msalaz03/ProjectClifford/README.md

# Project Clifford
* [Overview](#overview)
* [Setup](#setup)
  * [RVIZ with Clifford](#For-Using-RVIZ-With-Clifford)
  * [Launching Clifford](#For-Launching-and-Booting-Clifford)
* [Hardware](#hardware)
  * [Communication between Devices](#Communication-Protocol)
  * [FPV Camera](#FPV-Camera)
  * [Displaying Live Battery %](#Calculating-Battery-Life)
  * [Other Hardware](#Other-Useful-Components)
* [Software](#software)
* [Kinematics](#Inverse-Kinematics)
* [Future Additions](#future-additions)
* [Bill of Materials](#bill-of-materials)
* [References](#references)

## Overview (Please Read)
Over the past four months Cameron, Chase and I tried tackling our version of Boston Dynamic's Spot. This repository contains the source code that interfaces all hardware interactions between our small red friend. The software includes prebuilt libraries designed for the Raspberry Pi and also references other projects similar to ours. 

Now then, running on Ubuntu 22.04 LTS using ROS-Humble we went through a series of processes to organize this into a simple manner. However, we will note that they're some poor practices as a result of time constraints and it is our first time working with the ROS framework. These will be noted and clarified further in this document. Clifford is an entirely 3D-printed project that uses inverse kinematics to simulate a dog walking. Clifford also has an FPV camera mounted which can be accessed through any web browser provided you're on the same network as him.

Please check the references, this would have not been possible without open-source projects. 



## Video Demo:
https://youtube.com/shorts/WbrB4VmLomk?feature=share

## Setup
The organization of nodes is not ideal. However, with time it can be reorganized neatly. Currently, we have mostly everything inside a single node. For anyone attempting to recreate anything similar please take the time to do so before programming the entire project.

```
Three most important folders for this project.

projectclifford_ws/
│
├── src/
│   ├── clifford_sim_1
│   │   └── ...
│   ├── servo_driver
│   │   └── ...  
│   └── ...
│   ├── teleop_controller
│   │   └── ...  
│   └── ...
```

#### For Using RVIZ With Clifford
To test our kinematic equations more efficiently we used RVIZ to visualize what is happening when there is a controller input. 'clifford_sim_1' contains a URDF file for the final version of Clifford, exported through SolidWorks URDF exporter. The launch file within this directory only launches the URDF file into RVIZ and does not contain RobotStatePublisher by default. You can enable joint-state-publisher-gui by uncommenting the related lines within the launch file or can use an additional launch file that waits for joy (controller input) and joint-state-publisher topic. The second directory relative to running RVIZ is 'teleop_controller' which creates a topic for joint-state-publisher.

**NOTE:** This totally could have been organized into a single launch file but wasn't due to circumstances at the time.

In order to launch please do the following.

```
ros2 launch clifford_sim_1 clifford_sim_1.launch.py
ros2 launch teleop_controller Clifford_full_model.launch.py
```
#### For Launching and Booting Clifford

To physically launch Clifford is pretty simple (as long as you have all required dependecies), simply run the following command.

**Note:** At this point Clifford cannot physically turn as the turning motion was not programmed, however the kinematic equations needed to do are solved and within the software.
```
ros2 launch servo_driver joy_servos.launch.py
```

If you want don't want to follow Clifford, you can see where he is through livestreamed footage. First identify the IPV4 address of clifford and type the following.
```
xxx.xxx.xxx.xxx:8081
```

## Hardware
From researching similar projects to Clifford and our testing we sourced components that we thought were optimal for this project, consisting of two voltage regulators to isolate the power going into the servo driver and Raspberry Pi. An ADC board to measure different voltage levels into a relative percentage for battery life. A high-capacity battery to prolong battery life. LCD screen to demonstrate battery life in real time. 25 KG servos, a mixture of torque and speed to ensure smooth movements. 

<br>
  
<table>
  <tr>
    <td> <b>Electrical Component </b></td>
    <td>  <b>Model Name </b>  </td>
  </tr>

  <tr>
    <td>Controller</td>
    <td>Raspberry Pi 4B</td>
  </tr>

  <tr>
    <td> Camera </td>
    <td> Arducam 16MP Wide Angle USB Camera </td>
  </tr>
  
   <tr>
    <td>Voltage Regulator for Pi</td>
    <td>LM2596</td>
  </tr>

 <tr>
    <td>Voltage Regulator for Servos</td>
    <td>DROK DC-DC High Power </td>
  </tr>

 <tr>
    <td>LiPo Battery</td>
    <td>Zeee 2S LiPo 6200mAh @ 7.4V</td>
</tr>

 <tr>
    <td>Servos</td>
    <td>DS3225MG</td>
</tr>

 <tr>
    <td>Servo Driver</td>
    <td>PCA9685</td>
</tr>

 <tr>
    <td>ADC Board</td>
    <td>ADS1115</td>
</tr>

 <tr>
    <td>Gyroscope</td>
    <td>MPU-6050</td>
</tr>

 <tr>
    <td>LCD 16x2</td>
    <td>Sunfounder LCD1602 16x2 </td>
</tr>
 
</table>

#### Communication Protocol 
As we were using multiple third-party modules such as servo driver we utilized the I2C bus provided on the Raspberry Pi 4B. This worked perfectly but didn't allow us to have multiple devices using I2C, as we had a few more. Creating a simple PCB using header pins we created an I2C bus expander that allowed all devices to meet at a single point to communicate with the Pi.

#### FPV Camera 
Using motion libraries we were able to set up a first-person live-streaming feed on a local network. By dedicating a specified port to live-streaming (8081) simply use the IPV4 address followed by the port like so xxx.xxx.xxx.xxx:8081 to access from any device on the same network. 
To set the config file for the motion service to work navigate to:
```
sudo nano /etc/default/motion
```
Make the following changes to the config file:
```
daemon on
stream_localhost off
webcontrol_localhost off
framerate 1500
stream_quality 100
quality 100
width 640
height 480
post_capture = 5
```
After that navigate to the default file:
```
sudo nano /etc/default/motion
```
Make sure the file contains the following if you want live streaming to start when turning on the Pi.
```
start_motion_daemon=yes
```
#### Calculating Battery Life 
Using the 5V pin provided to power the ADS1150, we needed to step down the balance charger voltage outputted from the LiPo. We created a small PCB board that included a voltage divider circuit such that the highest voltage read would be ~5V. Now with voltage being able to be read, we then determined the highest voltage ie @ 100% and at 0%. We then used the current voltage to calculate the current battery percentage.

#### Other Useful Components  
After finalizing the project here our somethings that help improve production. 
  - Buy a dedicated LiPo Battery Balance Charger, these will guarantee the quality of battery being used and can charge relatively quick.
  - Using a DC Power Supply, would prevent the need of constantly recharging the battery after testing.
  - If possible maximize the hardware you use. We settled on the Raspberry Pi 4B, it was okay. I figured I would do most of my programming on the Pi anyway but there were times it was just so slow.
  - Get a dedicated cooler for your controller, especially for the Raspberry Pi. These things will heat up quickly.

## Software
The software went through many revisions, currently, all software is under a single node, 'servo2_pca9685' within the directory 'servo_driver'. This includes the various kinematic equations needed to move each leg. The ultrasonic sensor can also be found within this file to override a controller input if Clifford detects he is too close to an object.

#### PS4 Joystick
Using the left joystick, you can determine the direction of movement (forward or backward). This is handled through flags that check the joy topic axes sign (-/+). Using the Joy topic callback we can constantly update Clifford's relative position. Clifford's walking consists of a 4-point leg motion. However, the legs move in pairs, meaning the front left and back right move together, and the front right and back left move together. The overall structure of the walking gait was as follows, a single set will take 'charge' meaning they're the legs move forward while the others are dragging backward creating the ability to go forward. The speed at which the legs drag backward is based on the input of the user, and timing so that a pair of legs complete a single point (the ones dragging backward) while the other completes three 3 (the other set). This allows us to constantly have two points of contact with the ground at all times.

The leg motion follows a square pattern, making the programming straightforward. At each position, the program checks whether the leg is moving forward or backward and its current relative position (x, y, z). Only one coordinate (either x or y) changes at a time. Multiple conditions verify if the leg has passed or reached its target coordinate, then update the target and current indices. While most of the programming remains consistent, the conditions for each leg differ slightly.

#### Sample Code
```
     if forward and self.front_right_current[2] >= self.front_right_target[self.set1_target_index][2] or \
                        (not forward and self.front_right_current[2] <= self.front_right_target[3][2]):
                            self.update_servos()
                    else:
                        if forward:
                            self.front_right_current[2] = self.front_right_target[self.set1_target_index][2]
                            self.back_left_current[2] = self.back_left_target[self.set1_target_index][2]

                            self.set1_target_index = 2 
                            self.set1_walk_index = 1
                        else:
                            self.front_right_current[2] = self.front_right_target[self.set1_walk_index][2]
                            self.back_left_current[2] = self.back_left_target[self.set1_walk_index][2]
                            self.set1_walk_index = 3
                            self.set1_target_index = 0
                       
                        if not forward:
                            self.front_left_current[0] = self.front_left_target[self.set2_walk_index][0]
                            self.back_right_current[0] = self.back_right_target[self.set2_walk_index][0]
                            self.set2_walk_index = 3
                            self.set2_target_index = 0
```

#### PS4 Buttons

Various buttons are configured for the following. During this time it changes a flag so that clifford knows that he is no longer waiting for 'walk' commands. Additionally, for any third party expanders 
  - Lay down or stand tall.
  - Lean side to side.
  - Lean forward and backward.
  - Reset to default stance.
  - Shutdown Clifford.

#### LCD Node
We were unable to access the libraries outside their installation location, so creating a node with the LCD running via the launch file didn’t work. Instead, we created a separate Python script to run in parallel with the Clifford launch. Ideally, we would import the libraries into a dedicated node.

## Inverse Kinematics
We researched various walking gait patterns and quadruped motion analyses before attempting to model our robot's movements. The Inverse Kinematics for our robot consists of 2 main analyses - Forward/Backward and Lateral motions. We successfully implemented the Forward/Backward and Lateral inverse kinematics into RViz to help visualize and verify our math without any mechanical or electrical limitations. After verifying the calculations with RViz we slightly modified the inverse kinematics based on the servo rotation limits and how they were physically installed on the robot. For this reason, the calculations for the left and right sides of the robot are mirrored regarding the "arm" and "wrist" servo bounds. 

Due to time limitations, we were only able to implement the forward-backward motions onto the physical robot but solved the inverse kinematics for the lateral motions as well and will apply these in the future. 

After we programmed the inverse kinematics, we tested different gait designs and optimized the robots foot coordinate positions based its weight distribution. After extensive testing we were able to develop an effective forward and backward walking gait - however improvements can always be made.

Below are the inverse kinematic models we utilized:

<table>
  <tr>
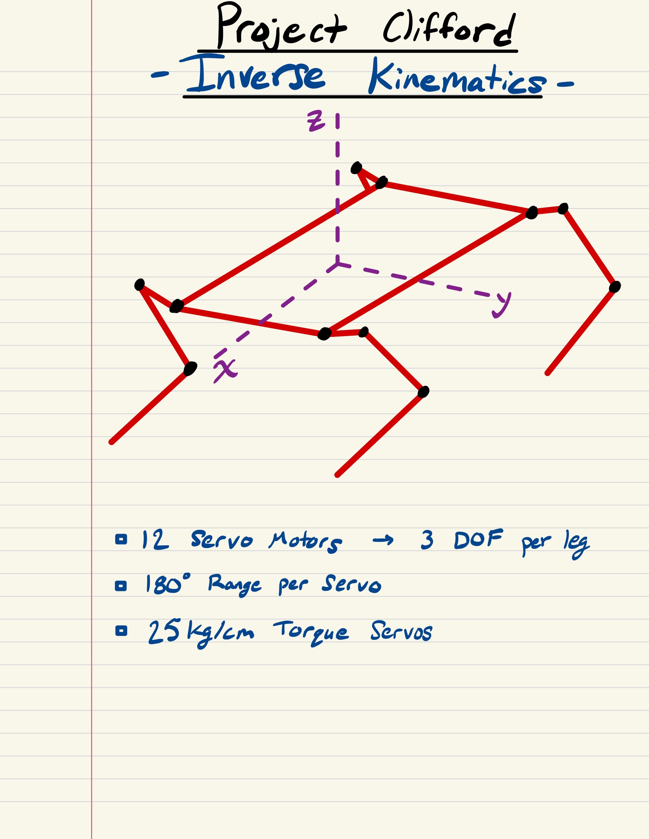
[picture p1: assets/Inverse Kinematics-2.jpg]
    <td></td>
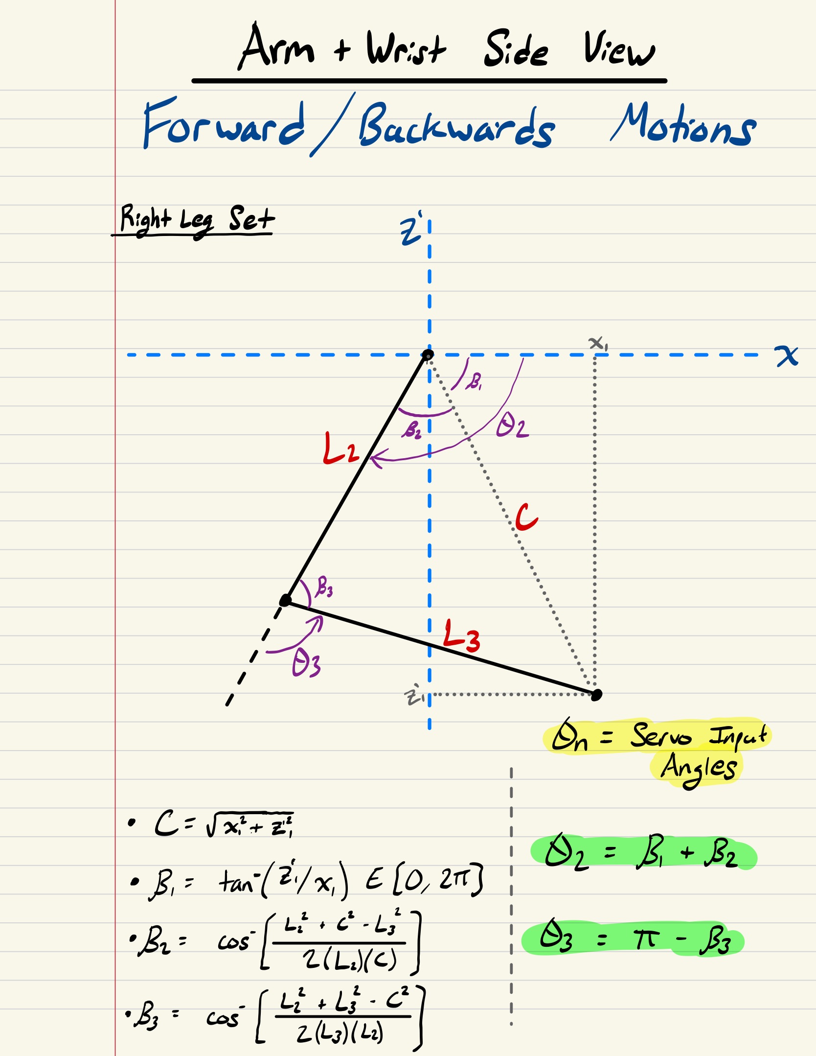
[picture p2: assets/Inverse Kinematics-3.jpg]
    <td></td>
  </tr>
  <tr>
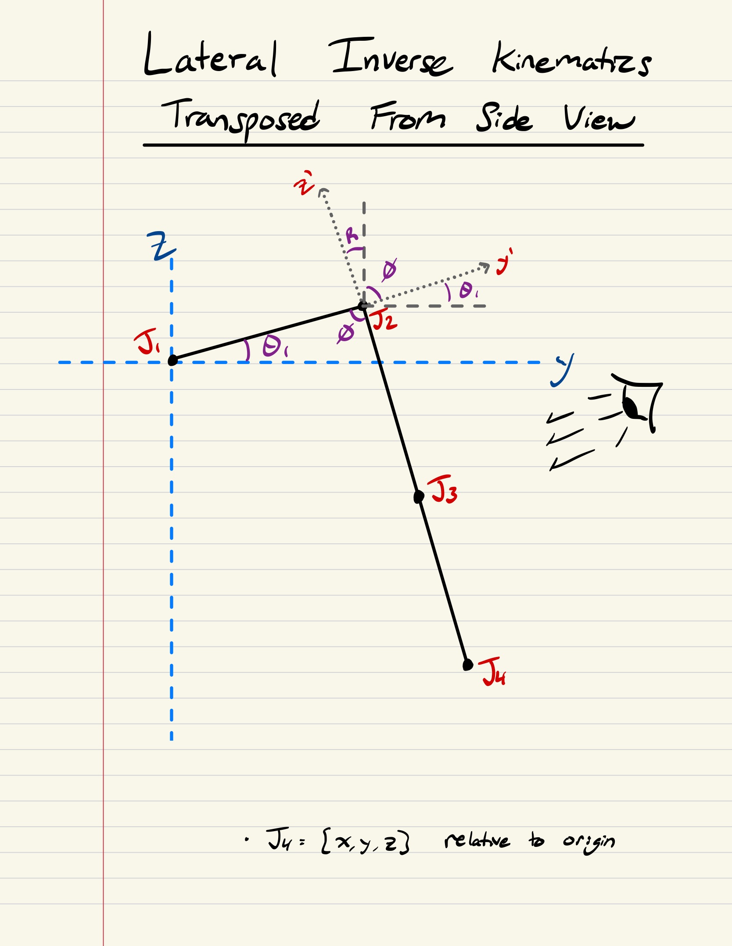
[picture p3: assets/Inverse Kinematics-4.jpg]
    <td></td>
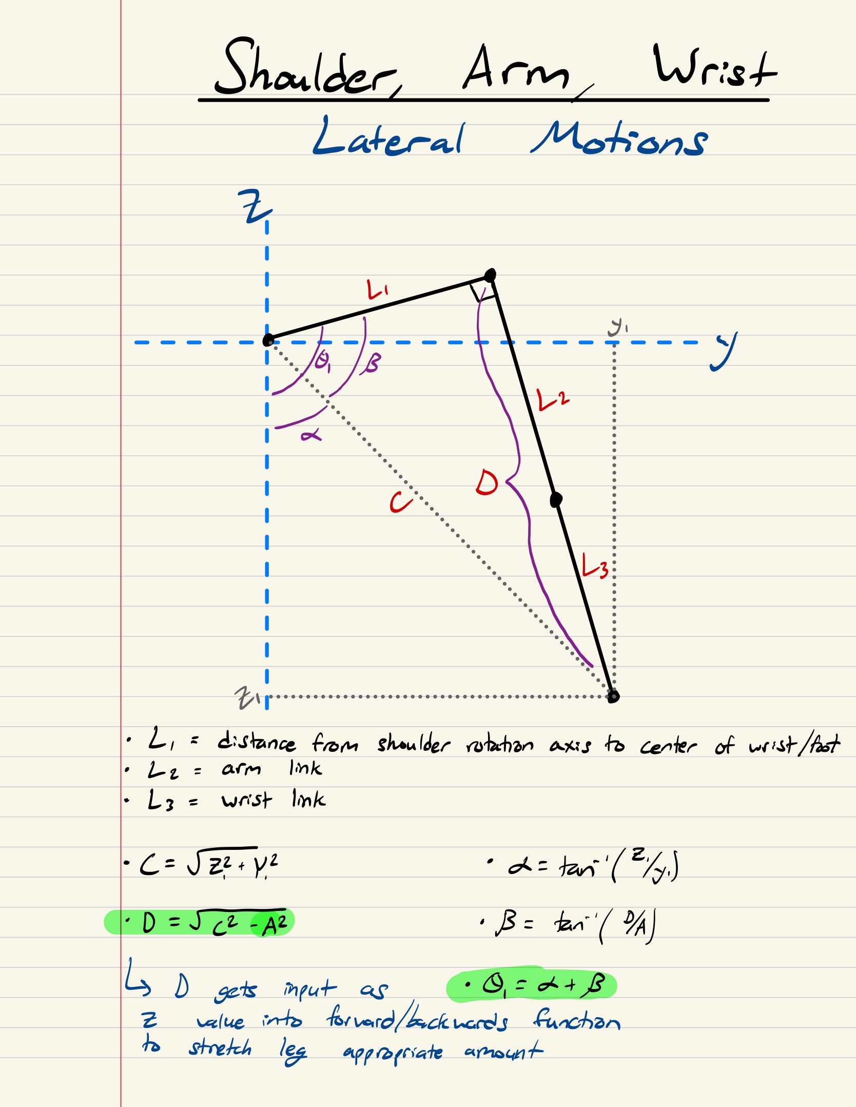
[picture p4: assets/Inverse Kinematics-5.jpg]
    <td></td>
  </tr>
  <tr>
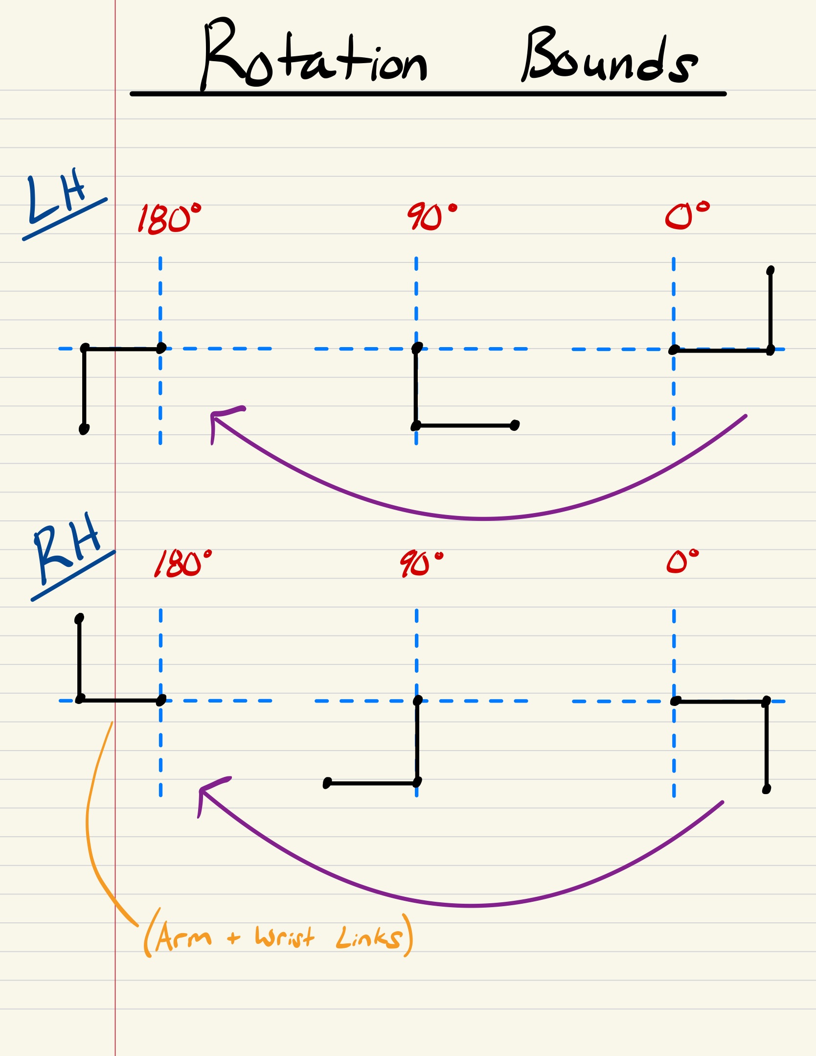
[picture p5: assets/64019C31-1EB6-4C09-A2AE-42A0C3EA9866.jpeg]
    <td></td>
  </tr>
</table>

References for Inverse Kinematics: <br>
<a href="https://www.youtube.com/watch?v=qFE-zuD6jok&t=464s">https://www.youtube.com/watch?v=qFE-zuD6jok&t=464s</a> <br>
<a href="https://www.youtube.com/watch?v=4rc8N1xuWvc&t=253s">https://www.youtube.com/watch?v=4rc8N1xuWvc&t=253s</a>

## Future Additions
We have several features and functionalities we hope to add in future revisions of Clifford. Our main constraint for this project was a small timeline and for this reason, we were not able to achieve all the features we initially planned.

The main feature we plan to develop is autonomous self-balancing with the gyroscope we already integrated into the system. We planned to implement self balancing in the x and y axis but due to time limitations we were unable to do so. This would improve walking stability and further the real-world application scope of the project.

Another future addition we would like to implement is additional status indicators. We would like to properly develop a ROS node for the LCD and add other status displays the user would be able to toggle between. We would also like to add LED status indicators based on the current mode of the robot.

## Bill of Materials
<table>
  <tr>
    <th>Component</th>
    <th>Quantity</th>
    <th>Total Cost</th>
  </tr>
  <tr>
    <td><a href="https://amzn.to/4ej0M4R">DS3225MG 25 Kg Servos x2</a></td>
    <td>6</td>
    <td>$264</td>
  </tr>
  <tr>
    <td><a href="https://amzn.to/3TkDkMs">LiPo Battery Charger</a></td>
    <td>1</td>
    <td>$51</td>
  </tr>
  <tr>
    <td><a href="https://amzn.to/3XDdNQ7">T deans T branch (Parallel) x2</a></td>
    <td>1</td>
    <td>$13</td>
  </tr>
  <tr>
    <td><a href="https://amzn.to/3XigNB1">Wire Strippers</a></td>
    <td>1</td>
    <td>$14</td>
  </tr>
  <tr>
    <td><a href="https://amzn.to/3zb0m1m">18 Gauge Wire 70 ft</a></td>
    <td>1</td>
    <td>$20</td>
  </tr>
  <tr>
    <td><a href="https://amzn.to/3TlbYGa">USB-C Charging cable x2</a></td>
    <td>1</td>
    <td>$14</td>
  </tr>
  <tr>
    <td><a href="https://amzn.to/4dXxEQW">7.4V 6200mAh Battery</a></td>
    <td>2</td>
    <td>$60</td>
  </tr>
  <tr>
    <td><a href="https://amzn.to/4dSKi3j">RPI Heatsink</a></td>
    <td>1</td>
    <td>$16</td>
  </tr>
  <tr>
    <td><a href="https://amzn.to/4gsuaHM">HDMI to Micro HDMI</a></td>
    <td>1</td>
    <td>$14</td>
  </tr>
  <tr>
    <td><a href="https://amzn.to/3MFj6JD">DROK RPI Buck Converter (used as spare)</a></td>
    <td>1</td>
    <td>$26</td>
  </tr>
  <tr>
    <td><a href="https://amzn.to/3B7LtgM">PCA Servo Driver</a></td>
    <td>2</td>
    <td>$26</td>
  </tr>
  <tr>
    <td><a href="https://amzn.to/3z0VImL">RPI 4B</a></td>
    <td>1</td>
    <td>$100</td>
  </tr>
  <tr>
    <td><a href="https://amzn.to/3ZckQ4z">T Deans Female-Male Adapters</a></td>
    <td>5</td>
    <td>$13</td>
  </tr>
  <tr>
    <td><a href="https://amzn.to/4e6M80A">DROK Servo Buck Converter</a></td>
    <td>1</td>
    <td>$20</td>
  </tr>
  <tr>
    <td><a href="https://amzn.to/3MDNZho">3D Print Filament</a></td>
    <td>1</td>
    <td>$25</td>
  </tr>
  <tr>
    <td><a href="https://amzn.to/4gekQqP">Micro SD Card</a></td>
    <td>1</td>
    <td>$13</td>
  </tr>
  <tr>
    <td><a href="https://amzn.to/4gdXHVp">ELEGOO 3D Printer</a></td>
    <td>1</td>
    <td>$339</td>
  </tr>
  <tr>
    <td><a href="https://amzn.to/3Xpz67E">F625zz Ball Bearings</a></td>
    <td>10</td>
    <td>$18</td>
  </tr>
  <tr>
    <td><a href="https://amzn.to/3zmVWEC">3A Buck Converter (for RPI)</a></td>
    <td>5</td>
    <td>$14</td>
  </tr>
  <tr>
    <td><a href="https://amzn.to/3Xyqa0R">USB-C to Wire</a></td>
    <td>4</td>
    <td>$14</td>
  </tr>
  <tr>
    <td><a href="https://amzn.to/3TmEsz0">Spray Paint (Red + Black)</a></td>
    <td>2</td>
    <td>$28</td>
  </tr>
  <tr>
    <td><a href="https://amzn.to/3Xjkma9">ADC Board</a></td>
    <td>1</td>
    <td>$11</td>
  </tr>
  <tr>
    <td><a href="https://amzn.to/47iyh4N">M3 Square Nuts</a></td>
    <td>100</td>
    <td>$11</td>
  </tr>
  <tr>
    <td><a href="https://amzn.to/4geTOzv">M4x20mm Bolts</a></td>
    <td>50</td>
    <td>$14</td>
  </tr>
  <tr>
    <td><a href="https://amzn.to/3TowMfU">M4 Square Nuts</a></td>
    <td>50</td>
    <td>$15</td>
  </tr>
  <tr>
    <td><a href="https://amzn.to/3Tktzhg">M3x10mm Bolts</a></td>
    <td>100</td>
    <td>$15</td>
  </tr>
</table>

## References
Special thanks to all these Open-Source Projects!

#### Other 'Spot' projects referenced
https://github.com/mike4192/spotMicro <br>
https://github.com/mangdangroboticsclub/mini_pupper_ros <br>

#### 3D Modelling. 
https://www.thingiverse.com/thing:3445283 <br>

#### Raspberry Pi Libraries for LCD 
https://github.com/the-raspberry-pi-guy/lcd <br>

#### Inverse Kinematic Equations
https://www.youtube.com/watch?v=qFE-zuD6jok&t=464s <br> 
https://www.youtube.com/watch?v=4rc8N1xuWvc&t=253s <br>

#### Other Useful Videos
https://www.youtube.com/@ArticulatedRobotics/videos (getting started with ROS) <br>
https://www.youtube.com/watch?v=Cr1ZshV-gqw&t=164s (Designing the walking gait) <br>
