msalaz03/ProjectClifford/assets/Inverse Kinematics-1.jpg

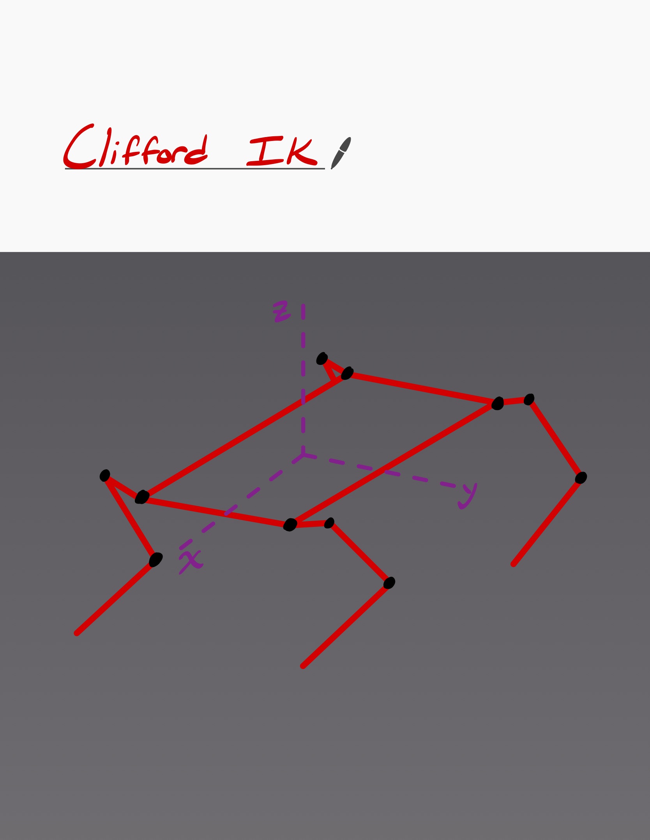
assets/Inverse Kinematics-1.jpg
