msalaz03/ProjectClifford/clifford_lcd/clifford_lcd/imgs/demo_backlight.gif

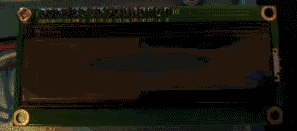
clifford_lcd/clifford_lcd/imgs/demo_backlight.gif
