msalaz03/ProjectClifford/clifford_sim_1/meshes/front_left_arm-link.STL

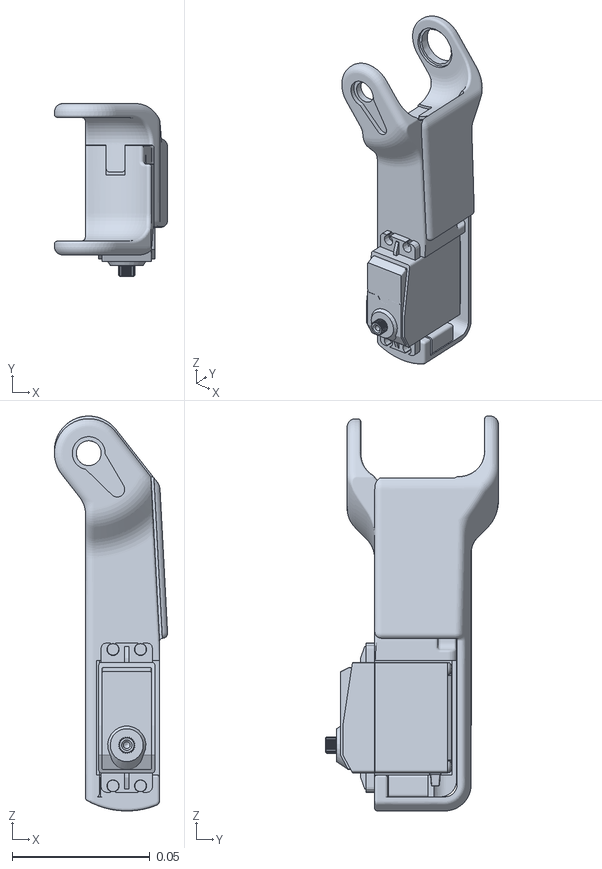
[picture p8: CAD file, 2024-07-23]
clifford_sim_1/meshes/front_left_arm-link.STL
0.0412 x 0.0628 x 0.144
