msalaz03/ProjectClifford/clifford_sim_1/meshes/front_left_wrist-link.STL

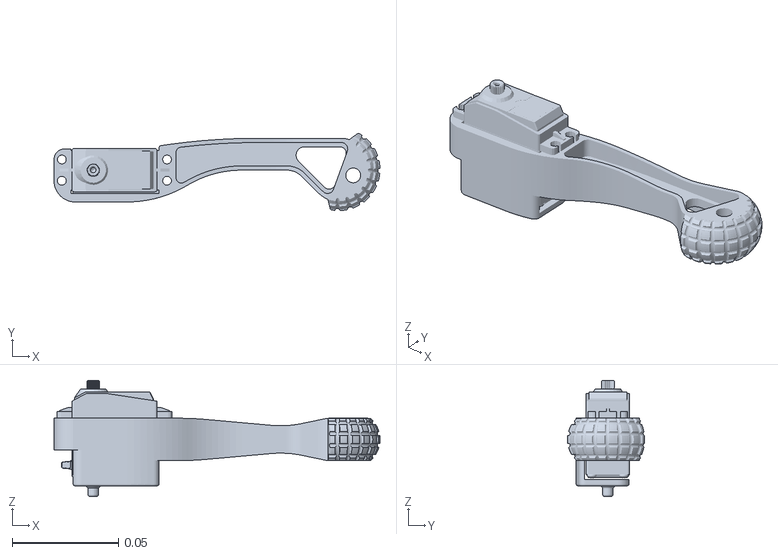
[picture p9: CAD file, 2024-07-23]
clifford_sim_1/meshes/front_left_wrist-link.STL
0.154 x 0.0364 x 0.0547
