msalaz03/ProjectClifford/left_leg_demo_new/meshes/base_link.STL

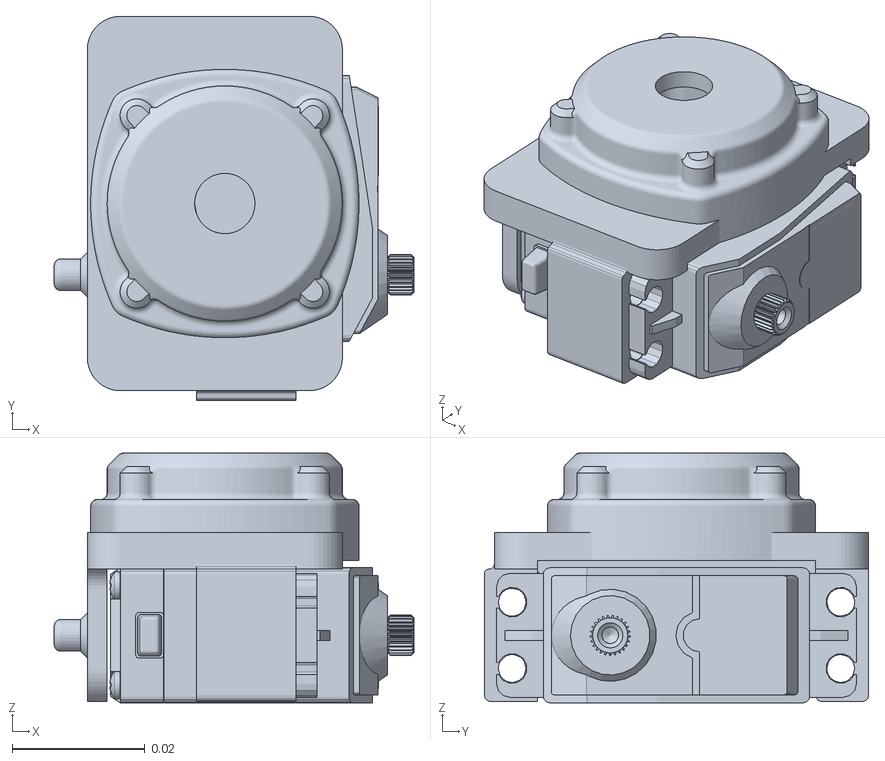
[picture p10: CAD file, 2024-06-08]
left_leg_demo_new/meshes/base_link.STL
0.0543 x 0.058 x 0.0377
