msalaz03/ProjectClifford/left_leg_demo_new/meshes/link_2.STL

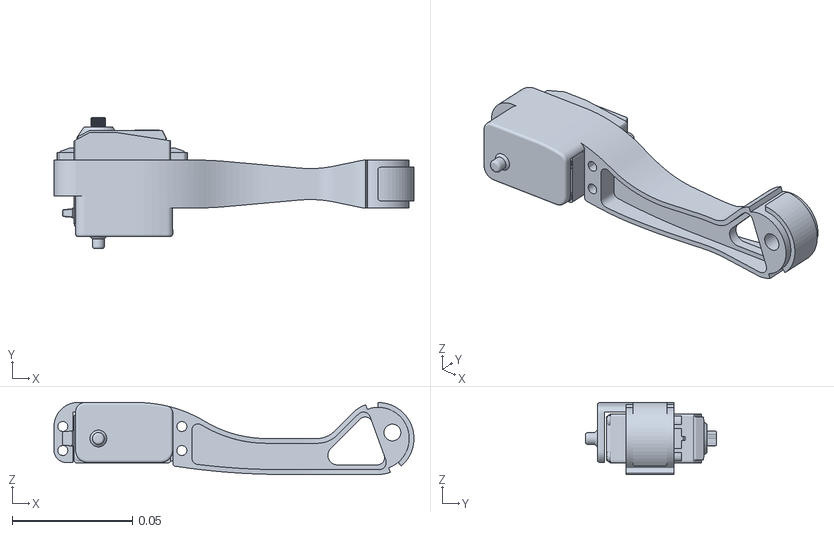
[picture p11: CAD file, 2024-06-08]
left_leg_demo_new/meshes/link_2.STL
0.15 x 0.0547 x 0.03
