msalaz03/ProjectClifford/clifford_sim_1/meshes/base_link_cover.STL

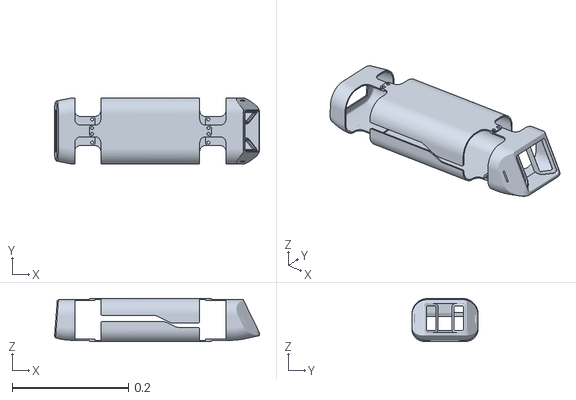
[picture p12: CAD file, 2024-07-23]
clifford_sim_1/meshes/base_link_cover.STL
0.353 x 0.114 x 0.074
