msalaz03/ProjectClifford/clifford_sim_1/meshes/base_link_chassis.STL

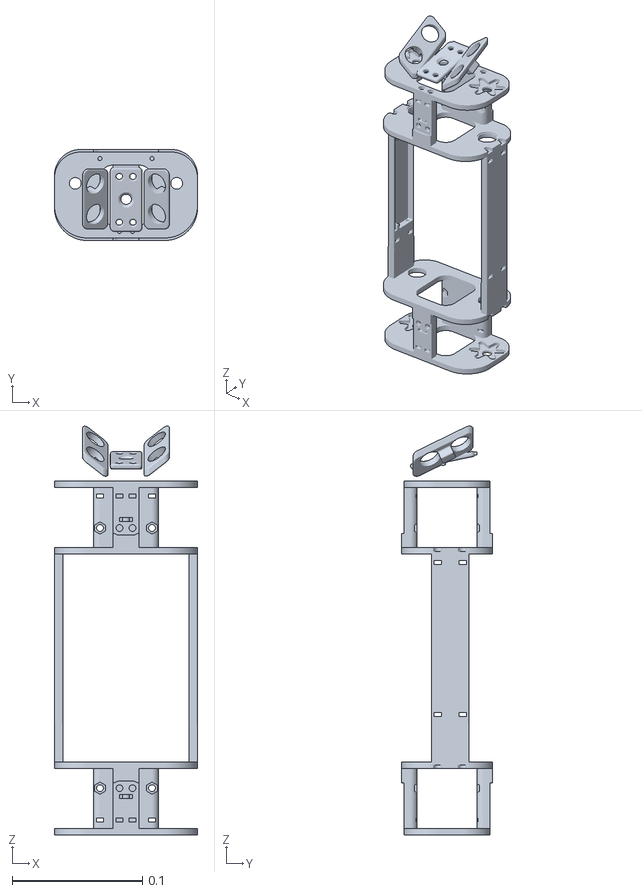
[picture p13: CAD file, 2024-07-23]
clifford_sim_1/meshes/base_link_chassis.STL
0.11 x 0.07 x 0.314
