msalaz03/ProjectClifford/(list of files, cad)

Other CAD files:
left_leg_demo_new/meshes/link_1.STL
clifford_sim_1/meshes/front_right_wrist-link.STL
clifford_sim_1/meshes/front_right_arm-link.STL
clifford_sim_1/meshes/rear_right_shoulder-link.STL
clifford_sim_1/meshes/rear_right_wrist-link.STL
clifford_sim_1/meshes/front_left_shoulder-link.STL
clifford_sim_1/meshes/rear_left_arm-link.STL
clifford_sim_1/meshes/rear_left_shoulder-link.STL
clifford_sim_1/meshes/front_right_shoulder-link.STL
clifford_sim_1/meshes/rear_left_wrist-link.STL
clifford_sim_1/meshes/rear_right_arm-link.STL
