msalaz03/ProjectClifford/servo_driver/pca9685_nodes/leg_coordinates_test.txt

        self.universal_shoulder_len = 58.17
        self.universal_arm_len = 107.00
        self.universal_wrist_len = 130.43

        #INIT OUR SERVO COORDINATE SYSTEM (TO DO)
        self.front_right_current = [130.43,58.17,107.0]
        self.front_left_current =  [130.43,58.17,107.0]
        self.back_right_current = [130.43,58.17,107.0]
        self.back_left_current = [130.43,58.17,107.0]

        self.front_right_target = [
            [130.43,58.17,107.0],
            [130.43,58.17,87.0],
            [150.43,58.17,87.0],
            [150.43,58.17,107.0]
        ]

        self.front_left_target = [
            [130.43,58.17,107.0],
            [110.43,58.17,107.0],
            [110.43,58.17,127.0],
            [130.43,58.17,127.0]
        ]
        
        self.back_left_target = [
            [130.43,58.17,107.0],
            [130.43,58.17,87.0],
            [150.43,58.17,87.0],
            [150.43,58.17,107.0]
        ]

        self.front_left_target = [
            [130.43,58.17,107.0],
            [110.43,58.17,107.0],
            [110.43,58.17,127.0],
            [130.43,58.17,127.0]
        ]

        =======================================================================================================

        self.universal_shoulder_len = 58.17
        self.universal_arm_len = 107.00
        self.universal_wrist_len = 200.43

        #INIT OUR SERVO COORDINATE SYSTEM (TO DO)
        self.front_right_current = [25.43,58.17,217.0]
        self.front_left_current = [25.43,58.17,217.0]
        self.back_right_current = [25.43,58.17,217.0]
        self.back_left_current = [25.43,58.17,217.0]

        self.front_right_target = [
            [25.43,58.17,217.0],
            [25.43,58.17,192.0],
            [50.43,58.17,192.0],
            [50.43,58.17,217.0],
        ]

        self.front_left_target = [
            [25.43,58.17,217.0],
            [0.43,58.17,217.0],
            [0.43,58.17,192.0],
            [25.43,58.17,192.0]
        ]
        
        self.back_left_target = [
            [25.43,58.17,217.0],
            [25.43,58.17,192.0],
            [50.43,58.17,192.0],
            [50.43,58.17,217.0]
        ]

        self.back_right_target = [
            [25.43,58.17,217.0],
            [0.43,58.17,217.0],
            [0.43,58.17,192.0],
            [25.43,58.17,192.0]
        ]

        =============================================

              self.front_right_current = [-30.43,58.17,157.0]
        self.front_left_current =  [-30.43,58.17,165.0]
        self.back_right_current = [-30.43,58.17,157.0]
        self.back_left_current = [-30.43,58.17,165.0]

        self.front_right_target = [
            [-30.43,58.17,157.0],
            [-30.43,58.17,142.0],
            [-10.43,58.17,142.0],
            [-10.43,58.17,157.0]
        ]

        self.front_left_target = [
            [-30.43,58.17,165.0],
            [-60.43,58.17,165.0],
            [-60.43,58.17,150.0],
            [-30.43,58.17,150.0]
        ]
        
        self.back_left_target = [
            [-30.43,58.17,165.0],
            [-30.43, 58.17,150.0],
            [-10.43,58.17,150.0],
            [-10.43, 58.17,165.0]

        ]

        self.back_right_target = [
            [-30.43,58.17,157.0],
            [-60.43,58.17,157.0],
            [-60.43,58.17,142.0],
            [-30.43,58.17,142.0]
        ]
