msalaz03/ProjectClifford/(commit log)

2024-06-11 fixed node executable issues
    [servo_pca9685.py]
2024-06-17 init updated leg
    [base_link.STL, left_leg_demo.urdf, link_1.STL, link_2.STL]
2024-07-04 new full dog model
    [clifford_sim_1.urdf]
2024-07-04 full model upload
    [base_link_chassis.STL, base_link_cover.STL, front_left_arm-link.STL, front_left_shoulder-link.STL, front_left_wrist-link.STL, front_right_arm-link.STL, front_right_shoulder-link.STL, front_right_wrist-link.STL]
2024-07-06 rviz full dog model all legs move
2024-07-17 servo driver test-code
2024-07-18 nodes init for servos
2024-07-19 kinematics for model solved
2024-07-23 latest kinematics
2024-07-25 one leg walking gait done (jittery)
    [servo_pca9685.py]
2024-07-29 one case completed of gait
2024-08-14 redesigned servo controller and added poses
    [servo2_pca9685.py]
